pratikPhadte/ESP32-Flight-controller-/resources/Circuit diagram _HANDDRAWN_ only IMU_01.pdf

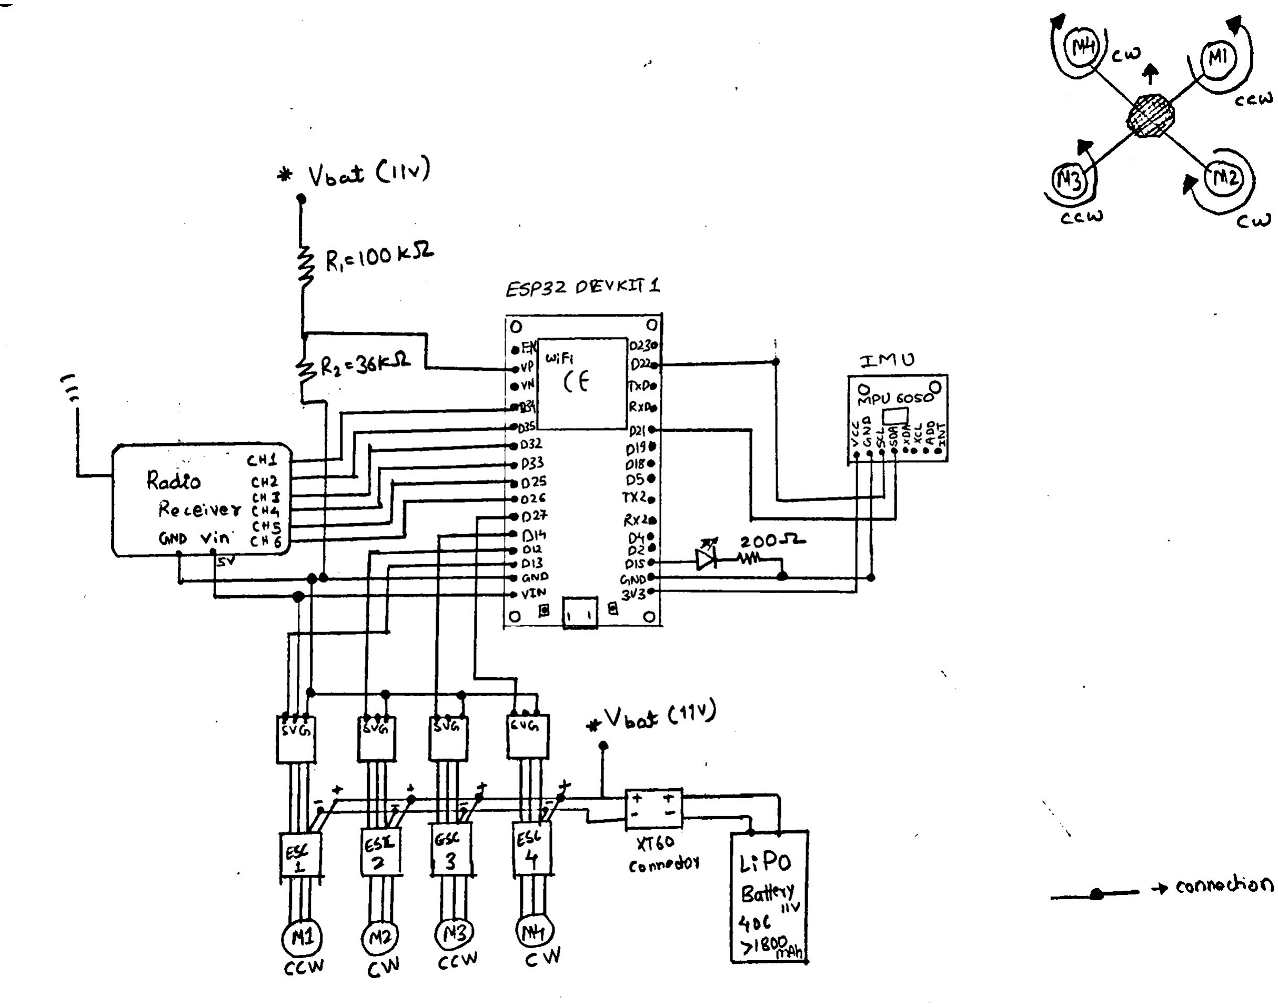
[picture p1: figure]
