pratikPhadte/ESP32-Flight-controller-/resources/Esp32 f450 frame quadcopter BOM.xlsx

ESP32 QUADCOPTER BILL OF MATERIALS
Sr No | Category | Item Desc | Qty Reqd | Unit Price(INR) | Total price(INR) | Total Quadcopter Cost(Excluding tools) | 11675
1 | Quadcopter | F450 / Q450 Quadcopter Frame – PCB Version Frame Kit with Integrated PCB – Made in INDIA | 1 | 800 | 800 | Flight contorller cost | 685
2 | Quadcopter | Flysky FS-i6X 2.4GHz 6CH AFHDS 2A RC Transmitter With FS-iA10B 2.4GHz 10CH Receiver | 1 | 4800 | 4800
3 | Quadcopter | A2212 1000 KV BLDC Brushless DC Motor with SimonK 30A ESC | 4 | 710 | 2840
4 | Quadcopter | Orange HD Propellers 8045(8X4.5) ABS Black 1CW+1CCW-1pair | 3 | 100 | 300
5 | Quadcopter | Orange 11.1V 2200mAh 40C 3S Lithium Polymer Battery Pack | 1 | 1800 | 1800
6 | Quadcopter | Lipo Battery Charger | Battery Balancer Charger 7.4-11.1V RC Pro Compact Charger B3AC | 1 | 450 | 450
7 | Flight controller | MPU-6050 3-Axis Accelerometer and Gyro Sensor | 1 | 115 | 115
8 | Flight controller | ESP32 DEV KIT DO IT 1 | 1 | 400 | 400
9 | Flight controller | 5 x 7 cm Universal PCB Prototype Board | 1 | 30 | 30
10 | Flight controller | LED | 1 | 10 | 10
11 | Flight controller | Resistors 220 ohms | 1 | 10 | 10
12 | Flight controller | Single strand wire (1m) | 1 | 40 | 40
13 | Flight controller | Berg pin male strip | 2 | 20 | 40
14 | Flight controller | Berg pin female strip | 2 | 20 | 40
15 | Tools & adhesives | Soldering Iron | 1 | 300 | 300
16 | Tools & adhesives | Soldering wire | 1 | 50 | 50
17 | Tools & adhesives | Soldering flux | 1 | 20 | 20
18 | Tools & adhesives | Double sided tape roll | 1 | 50 | 50
19 | Tools & adhesives | Zipties (15cm long) packet | 1 | 60 | 60
20 | Tools & adhesives | Wire cutter | 1 | 50 | 50
21 | Tools & adhesives | Insulation tape | 1 | 20 | 20
22 | Tools & adhesives | Allen Key for M2,M3 & M4 Grub Screw | 1 | 40 | 40
