pratikPhadte/ESP32-Flight-controller-/resources/ESP32 Quad FC_schematic.pdf

EN | ESP32

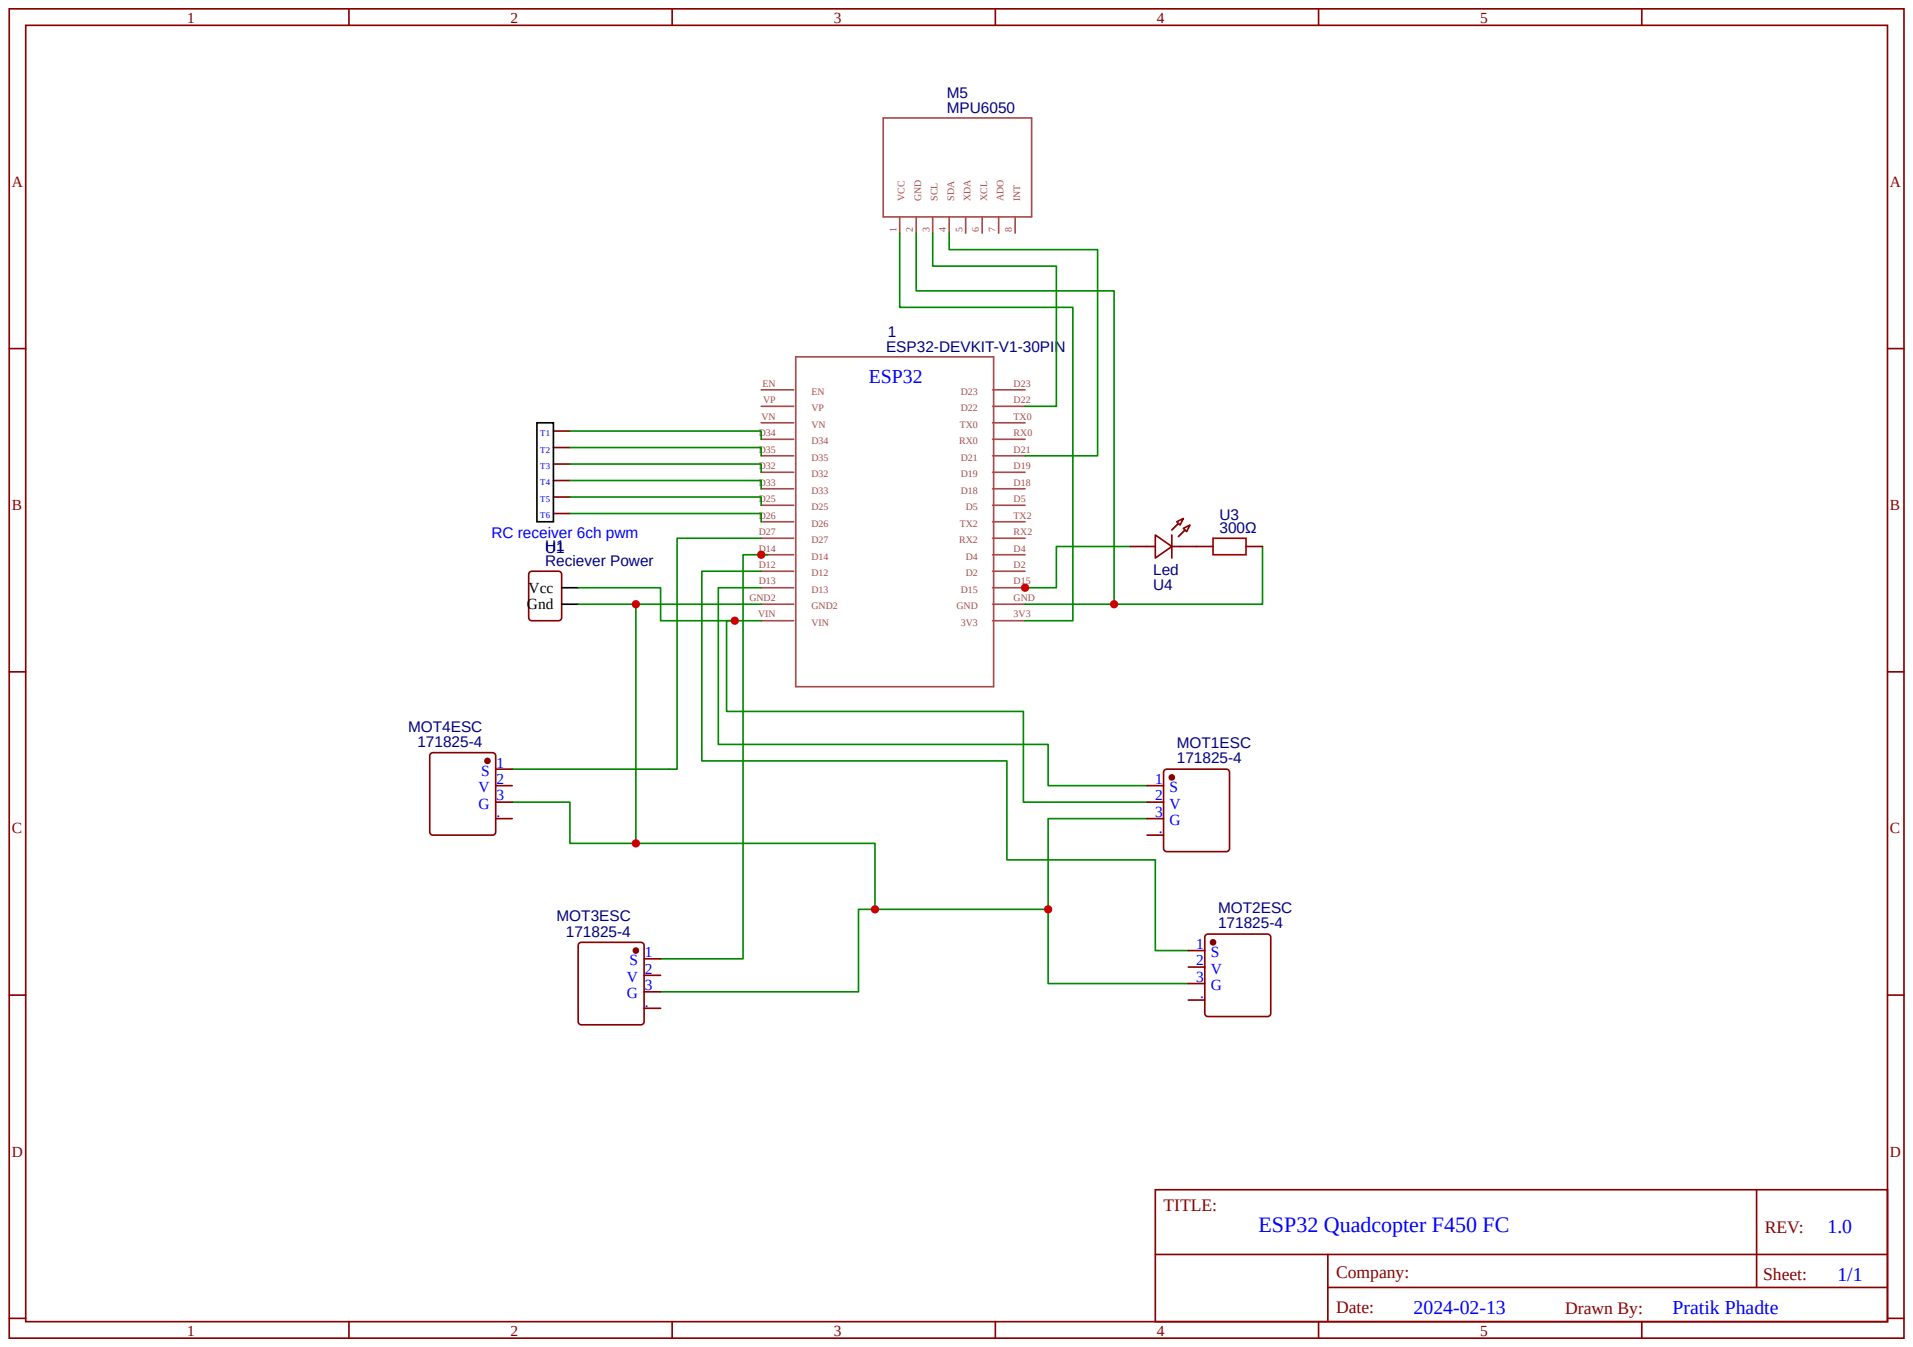
[picture p2: page 1]
