pratikPhadte/ESP32-Flight-controller-/(commit log)

2023-12-15 Add files via upload
    Photos of the diy esp32 flight controller
2023-12-25 Add files via upload
    This file contains web server PID value tuning option for the quadcopter
2024-01-06 Add files via upload
    Old file had wrong I2C pins connection, this one has the correct pin connection.
2024-01-15 Update Anglemode_flightcontroller_ver3.ino
    YAW pid values changed to give better result. IrateYaw from 1.2 to 2.8
2024-01-17 Add files via upload
    BOM for ESP32 quadcopter using f450 frame
    [Esp32 f450 frame quadcopter BOM.xlsx]
2024-01-17 Update Anglemode_flightcontroller_ver3.ino
    better pid values for f450 frame
2024-01-17 Update anglemode_flightcontroller_ver3_PID_values_tuning_webserver.ino
    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
2024-04-11 Add files via upload
    Clear schematic of circuit, made via EasyEDA
2024-11-09 Update anglemode_flightcontroller_ver3_PID_values_tuning_webserver.ino
    fixed Pitch PID values update , fucntion inlining for optimised code performance.
2024-11-09 Add files via upload
    calibrate IMU and accelerometer before uploading the anglemode_ver3 code
2024-11-23 new structure
    [Esp32 f450 frame quadcopter BOM.xlsx]
2025-02-03 Added Complementry Filter Webserver code
2025-03-18 Gerber File ESP32 FC
2025-03-18 PCB Gerber file in Resources
